RoboMechanix/TriFlameX/firmware/esp32/lidar/BLSER_demo/BLSER_interface.h

#ifndef BLSER_INTERFACE_H
#define BLSER_INTERFACE_H

#include "Arduino.h"
#define print_counter true
#define print_reff_counter true
#define print_speed true
#define print_error true
#define kp 1.5
#define kd 10.0
#define tolerance 1
#define angle_per_step 1.8

extern volatile int counter;
extern volatile bool is_cw;

void BLSER_init(uint8_t pwm_pin, uint8_t dir_pin, uint8_t encA, uint8_t encB, uint8_t b_pin);
void BLSER_moveTo(float angle);
void IRAM_ATTR handleInterrupt();

#endif
