RoboMechanix/TriFlameX/(commit log)

2025-04-07 Added templete Test files
    [SensorData.csv]
2025-04-07 Added STM32 WS
2025-05-04 implementing the PWM in TIMR peripheral
2025-05-04 implementing the PWM in TIMR peripheral except the pin initialization part
2025-05-04 fixing a bug in the GPIO of zeroing the whole register and completing the pwm mode
    [main.c]
2025-05-04 playing with ADC + PWM :)
2025-05-04 fixing small syntax error in the delay
    [main.c]
2025-05-04 added millis using ccr1
2025-05-04 Overwrite main with fix-branch content
    [main.c]
2025-05-05 implementing a driver for servo
2025-05-05 readded millis
2025-05-08 Created Motor Struct
2025-05-08 Integerated pwm into motor
2025-05-25 Added comunication flow illustrations
2025-05-25 Configured esp32 for VScode
2025-05-25 used millis instead of delay
2025-05-25 Tested the built LED and burnning code through vsCode
    [main.cpp]
2025-05-25 Made the broker and the client share the same subnet group
    [main.cpp]
2025-05-26 Implemented Transmission methods via UART
2025-05-26 pass Laptop commands to stm32
2025-05-26 yay i did UART
2025-05-26 dvided the sensor topic into 3 diff topics
2025-05-27 implemented UART_receive_command logic
2025-05-27 adding very spaghetti lidar driver sorry guys :)
2025-05-27 working millis now yayyyy
2025-05-28 Created A test scenario for UART
2025-05-28 Tested UART with float num
2025-05-29 Tested the distance through stm32cubeIDE debugging
2025-05-29 implemented the new UART sending logic in esp32
2025-05-29 publishing delay considered as timeout for the esp32 - fixed
    [main.cpp, mqtt_utils.cpp]
2025-05-29 changed the UART msg type
2025-05-30 demo servo driver
2025-05-31 Enabled switch between cars
2025-06-01 Successfully switching between MODES
2025-06-01 Implemented the manual mode in the esp32
2025-06-01 removed debugging print statements
2025-06-02 edited lidar settings
2025-06-02 fixed control and added main test
    [Lidar.ino, main.c]
2025-06-03 removed debugging print statment
2025-06-03 configured FreeRTOS on stm32
2025-06-05 adding the lidar_stepper driver
2025-06-05 adding lidar stepper driver
2025-06-05 making the lidar reads every sweep and finds the mean
2025-06-05 Fixing bool flags issue
    [comms.cpp, main.cpp, main.h, mqtt_utils.cpp, serial_utils.cpp]
2025-06-05 tested comms from esp32 side
2025-06-05 enhancing the stability of the joy reading
    [main.c]
2025-06-05 fixed a little control
    [main.c]
2025-06-05 fixed a little angle control
    [main.c]
2025-06-06 modifying the control a bit and adding another steering control function that returns if the angle of the robot in the desired position
2025-06-06 adding some configurations for the steering and linear velocity max speeds
2025-06-06 just cleaning and making the control driver more organized
2025-06-06 implemented speed switching logic
2025-06-07 Reverted file to what is before the merge
    [main.c]
2025-06-07 Tested Blue CAR's comms and motor
2025-06-08 addign lidar visualization script
2025-06-08 Figured out a way to go reverse
    [comms.cpp, main.c, mqtt_utils.cpp]
2025-06-08 Burnned the updated-code on the car
    [main.c]
2025-06-08 last version of working lidar
2025-06-09 working prototypeeee
2025-06-09 adding good lidar stepper file
2025-06-09 fixing the non sending bug
    [Lidar_stepper.ino]
2025-06-09 merging lidar and comm
2025-06-09 successful working networking lidar and comm
2025-06-11 fixed casting unsigned angle to sign anlge
    [serial_utils.cpp, serial_utils.h]
2025-06-11 switched joyHandler method from signed angle to unsigned
2025-06-11 Modified the STM UART accordingly
2025-06-11 added a new function to eliminate the freertos switching effect
2025-06-11 used sheemy method for updating angle but didn't work
    [main.c]
2025-06-12 fixing the lidar
2025-06-12 Converted UART from polling to Interrupts
2025-06-13 VERY IMPORTANT FIX TAKE IT
    [main.c]
2025-06-13 tried testing moving the motors with the latest update
2025-06-13 successfully made it compatible with the stm32
2025-06-13 printing errors only when it's a realtive error
2025-06-14 Added the flow chart for comms
2025-06-14 renamed comms flow chart and created a dir for the pics
2025-06-15 Added a new photo for the Lidar
